RKMason/Subwoofer_3D_Print/Subsonic Mk3 Spec Sheet.pdf

# Subsonic Mk3

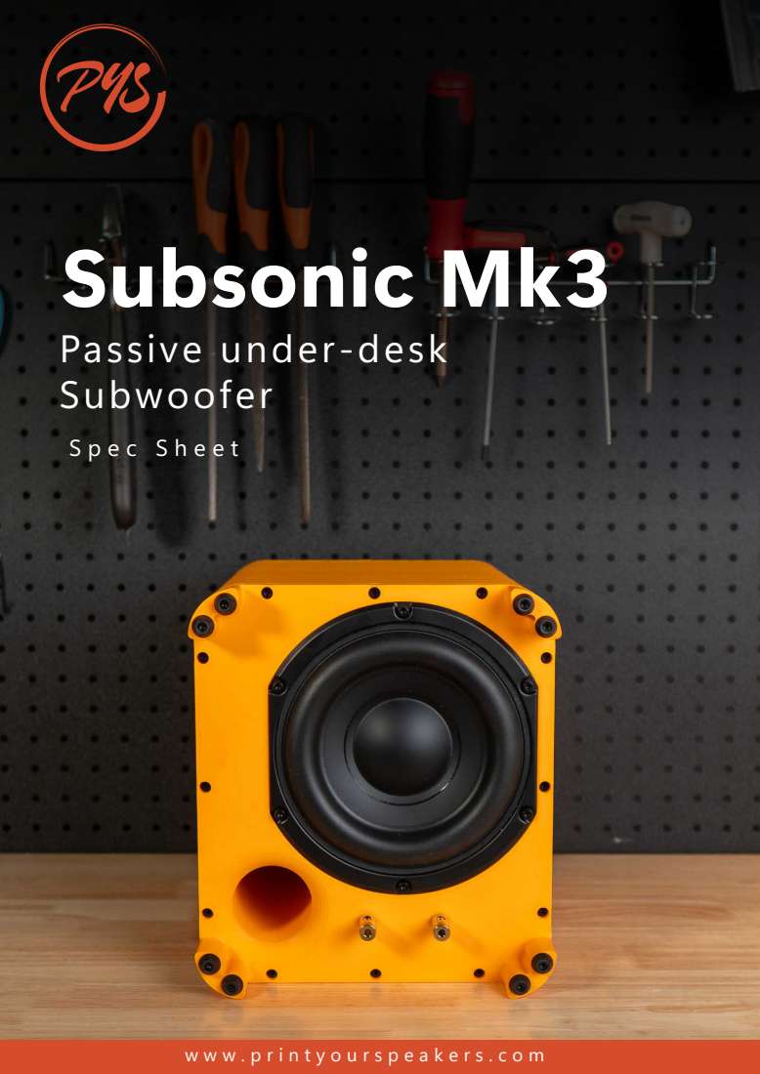
[picture p1: page 1]
Spec Sheet

Passive under-desk
Subwoofer

www.printyourspeakers.com

# SUBSONIC MK3 SPEC SHEET

## Description:

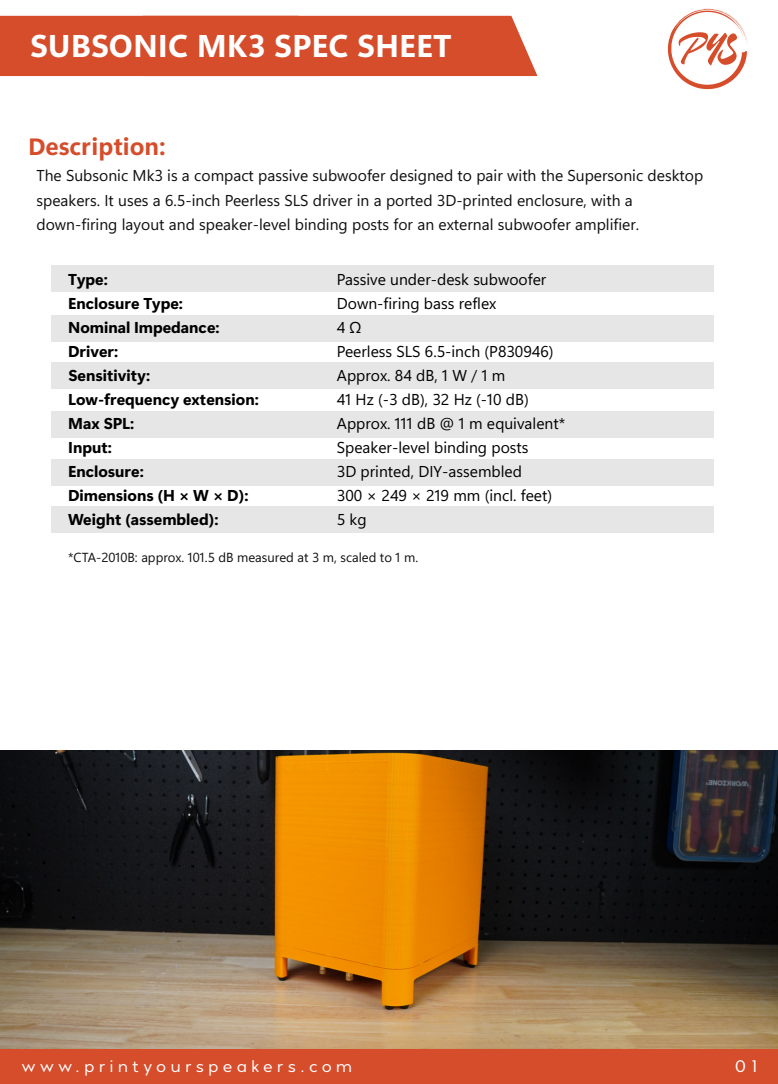
[picture p2: page 2]
www.printyourspeakers.com

The Subsonic Mk3 is a compact passive subwoofer designed to pair with the Supersonic desktop
speakers. It uses a 6.5-inch Peerless SLS driver in a ported 3D-printed enclosure, with a
down-firing layout and speaker-level binding posts for an external subwoofer amplifier.

Type:
Enclosure Type:
Nominal Impedance:
Driver:
Sensitivity:
Low-frequency extension:
Max SPL:
Input:
Enclosure:
Dimensions (H × W × D):
Weight (assembled):

Passive under-desk subwoofer
Down-firing bass reflex
Peerless SLS 6.5-inch (P830946)
Approx. 84 dB, 1 W / 1 m
Approx. 111 dB @ 1 m equivalent*
Speaker-level binding posts
3D printed, DIY-assembled
300 × 249 × 219 mm (incl. feet)

*CTA-2010B: approx. 101.5 dB measured at 3 m, scaled to 1 m.

# FREQUENCY RESPONSE & OUTPUT

*Ground-plane measurement at 1 m, 2 V (1 W into 4 Ω), no EQ. Approx. 84 dB sensitivity; 41 Hz (-3 dB), 32 Hz (-10 dB).

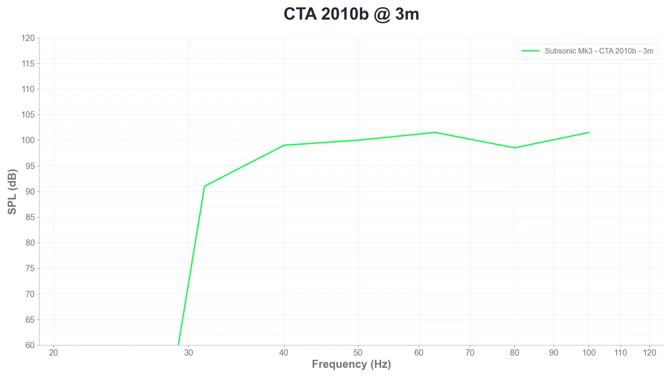
[picture p3: figure]

*CTA-2010B measured at 3 m; maximum approx. 101.5 dB. 1 m equivalent: approx. 111 dB (3 m measurement + 9.54 dB).

# IMPEDANCE

# MK2 VS MK3

*Frequency response comparison at 2 V (1 W into 4 Ω).

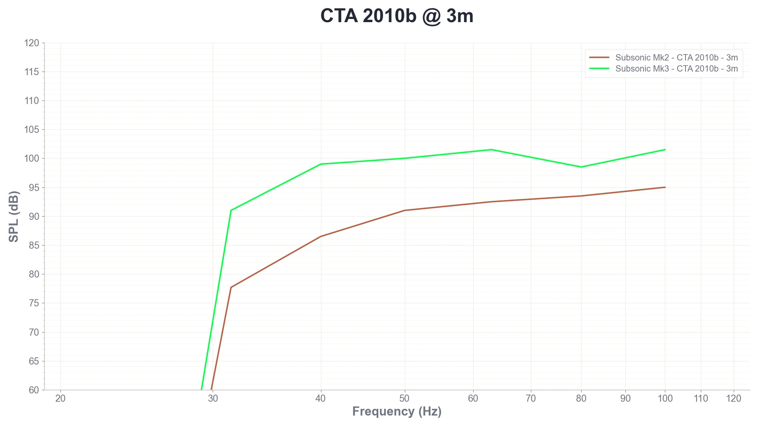
[picture p4: figure]

*CTA-2010B maximum output comparison, measured at 3 m.
