RKMason/Subwoofer_3D_Print/Baffle.step

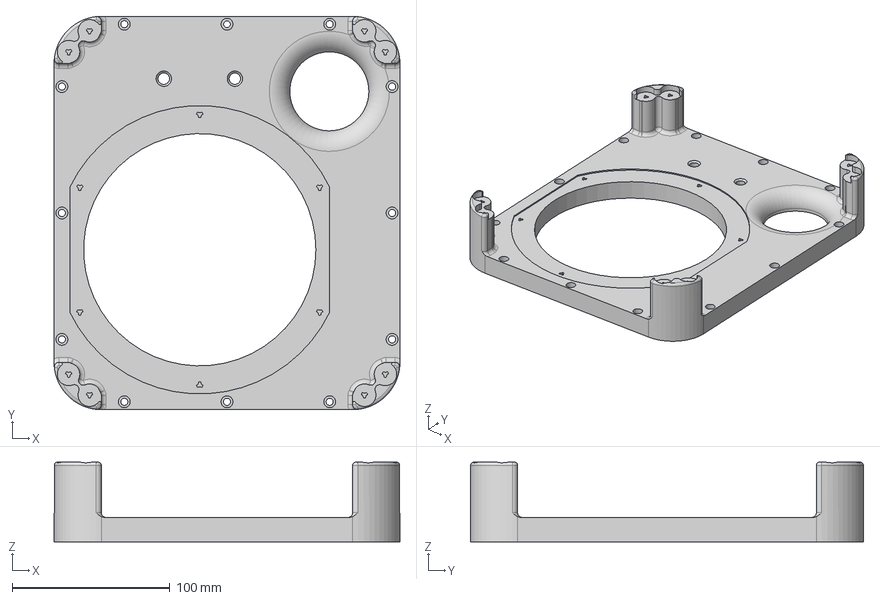
[picture p5: CAD file, 2026-09-30]
Baffle.step
219.0 x 249.0 x 50.5 mm
