RKMason/Subwoofer_3D_Print/Enclosure.step

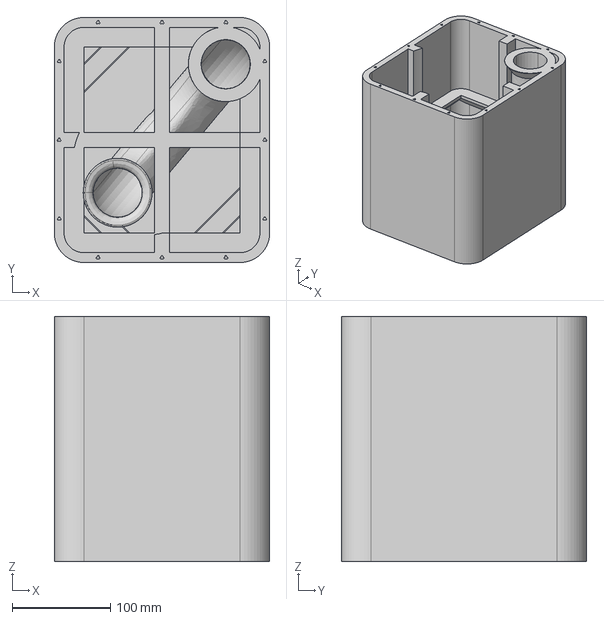
[picture p6: CAD file, 2026-09-30]
Enclosure.step
219.0 x 249.0 x 249.0 mm
