RKMason/Subwoofer_3D_Print/Bind Post Nut Driver.stl

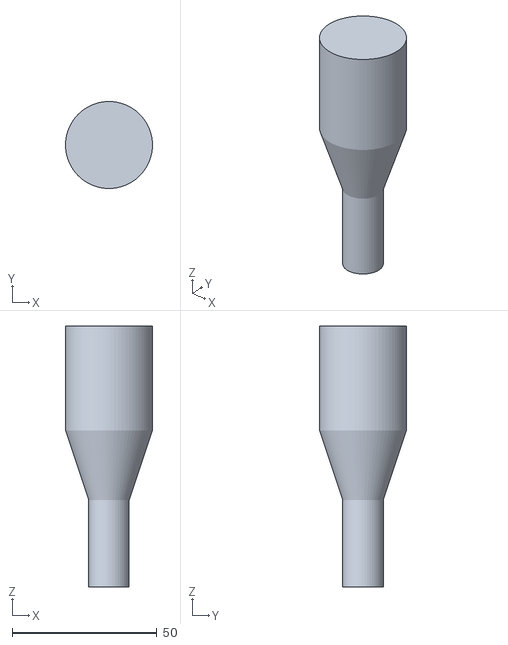
[picture p7: CAD file, 2026-10-03]
Bind Post Nut Driver.stl
30.0 x 30.0 x 90.0
