RKMason/Subwoofer_3D_Print/(list of files, cad)

Other CAD files:
Binding Post Nut Driver.step
Baffle.stl
Enclosure.stl
