RKMason/Subwoofer_3D_Print/Subsonic Mk3 Parts and Purchase Guide.pdf

# Subsonic Mk3

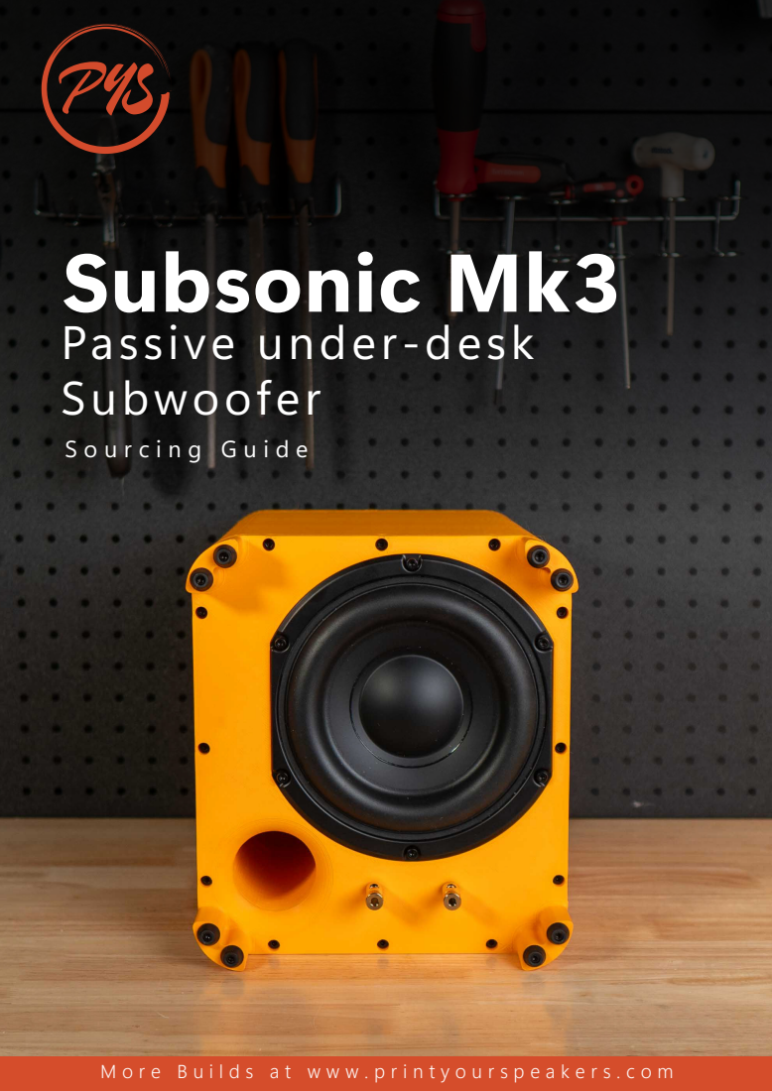
[picture p8: page 1]
Sourcing Guide

Passive under-desk
Subwoofer

More Builds at www.printyourspeakers.com

# SOURCING GUIDE

## Parts for one Subsonic Mk3

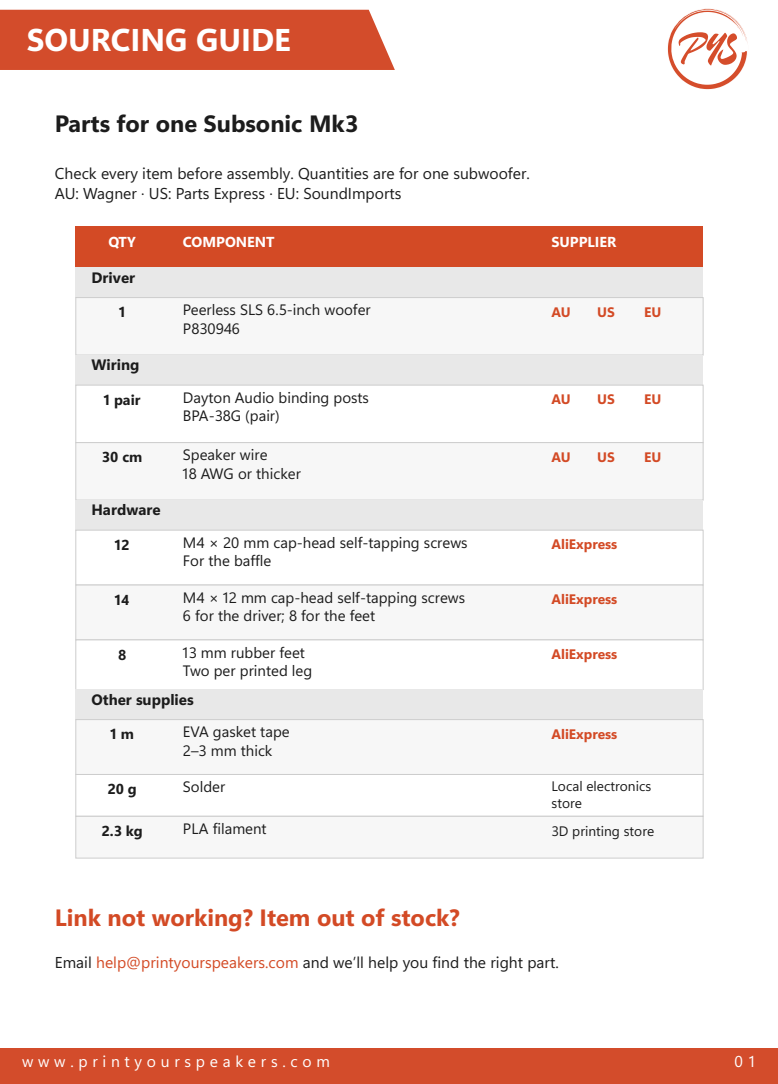
[picture p9: page 2]
www.printyourspeakers.com; QTY; COMPONENT; SUPPLIER; Driver; Peerless SLS 6.5-inch woofer; Wiring; 1 pair; Dayton Audio binding posts; BPA-38G (pair); Speaker wire; Hardware; M4 × 20 mm cap-head self-tapping screws; AliExpress; M4 × 12 mm cap-head self-tapping screws; 13 mm rubber feet; Other supplies; EVA gasket tape; 2–3 mm thick; Solder; Local electronics; store; PLA filament; 3D printing store

Check every item before assembly. Quantities are for one subwoofer.
AU: Wagner · US: Parts Express · EU: SoundImports

18 AWG or thicker

For the baffle

6 for the driver; 8 for the feet

Two per printed leg

Link not working? Item out of stock?

Email help@printyourspeakers.com and we’ll help you find the right part.
