RKMason/Subwoofer_3D_Print/Subsonic Mk3 Passive Assembly Guide.pdf

# Subsonic Mk3

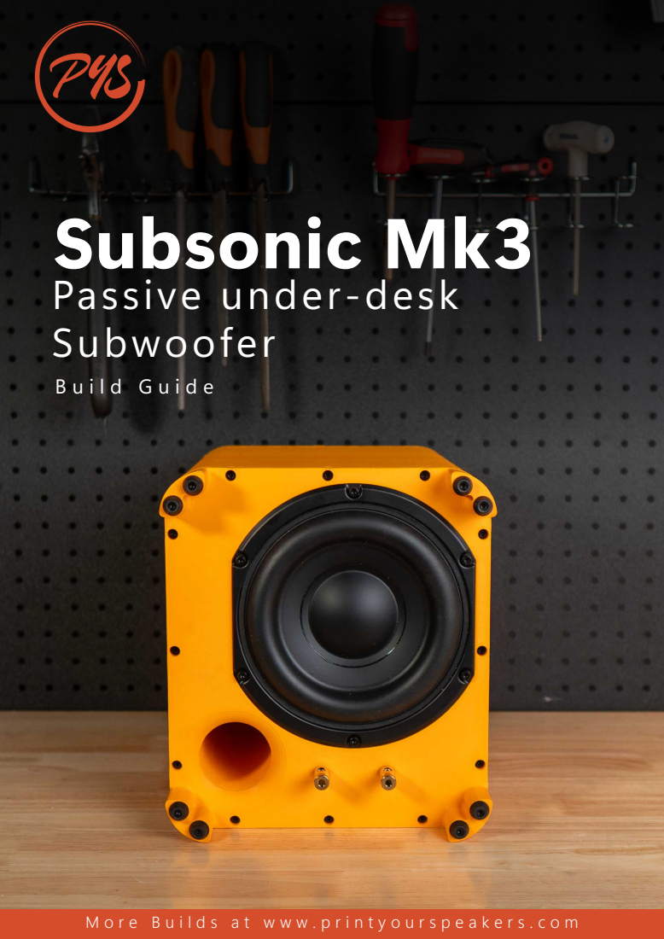
[picture p10: page 1]
Build Guide

Passive under-desk
Subwoofer

More Builds at www.printyourspeakers.com

# BEFORE YOU START

## You’re in the right place

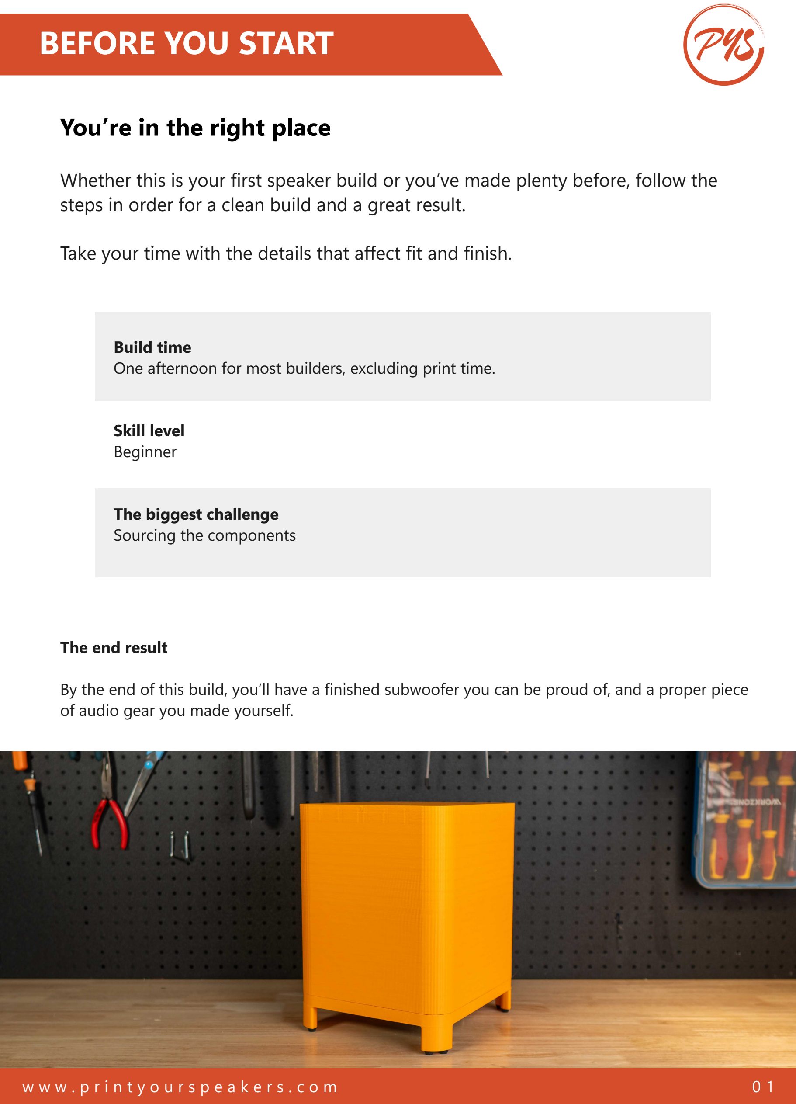
[picture p11: page 2]

www.printyourspeakers.com | 01

### Whether this is your first speaker build or you’ve made plenty before, follow the

steps in order for a clean build and a great result.

Take your time with the details that affect fit and finish.

Build time
One afternoon for most builders, excluding print time.

Skill level
Beginner

The biggest challenge
Sourcing the components

The end result

By the end of this build, you’ll have a finished subwoofer you can be proud of, and a proper piece of audio gear you made yourself.

Gather these tools and supplies for the build.

# TOOLS AND SUPPLIES

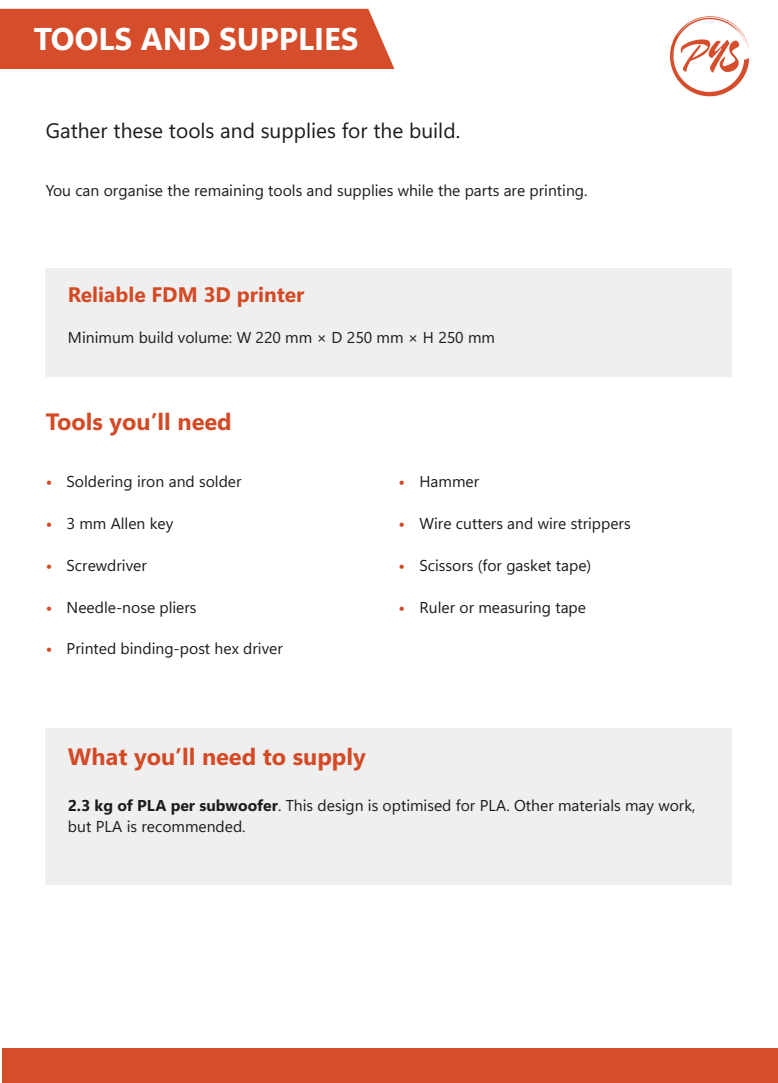
[picture p12: page 3]
• Screwdriver; • Hammer

You can organise the remaining tools and supplies while the parts are printing.

Reliable FDM 3D printer

Minimum build volume: W 220 mm × D 250 mm × H 250 mm

Tools you’ll need

• Soldering iron and solder

• 3 mm Allen key

• Wire cutters and wire strippers

• Scissors (for gasket tape)

• Needle-nose pliers

• Ruler or measuring tape

• Printed binding-post hex driver

What you’ll need to supply

2.3 kg of PLA per subwoofer. This design is optimised for PLA. Other materials may work,
but PLA is recommended.

PLA (tested and validated)

## Recommended material

# 3D PRINTING SETTINGS

## These settings have been tested on common FDM printers to

produce parts that fit and assemble correctly.

Other materials may work, but this build guide assumes PLA.

Parts are pre-oriented for printing. Do not rotate them.

## Part orientation

Check the orientation against the examples on the next page.

The main enclosure may take 48 hours or more to print. This is normal.

## Print time

The baffle may print in as little as a few hours.

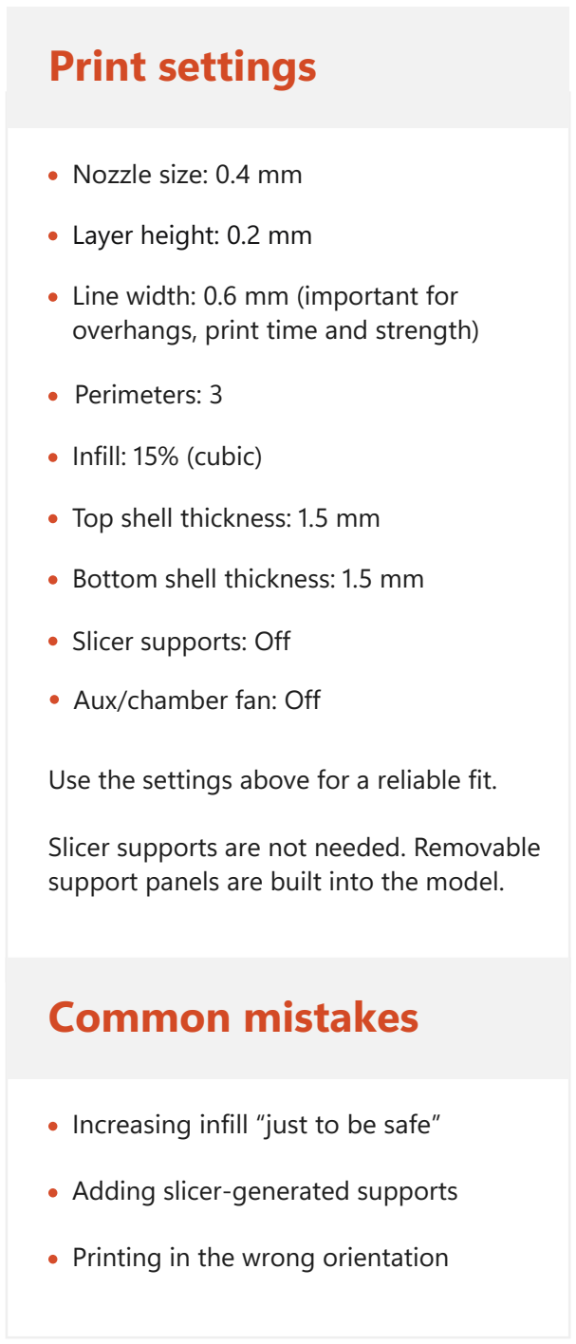
[picture p13: figure]
Nozzle size: 0.4 mm; Print settings; Layer height: 0.2 mm; Perimeters: 3; Top shell thickness: 1.5 mm; Bottom shell thickness: 1.5 mm; Slicer supports: Off; Increasing infill “just to be safe”; Common mistakes; Adding slicer-generated supports; Infill: 15% (cubic); Printing in the wrong orientation; Line width: 0.6 mm (important for overhangs, print time and strength); Aux/chamber fan: Off

Use the settings above for a reliable fit.

Slicer supports are not needed. Removable support panels are built into the model.

Load the parts into your slicer to check the time on your printer.

Start with the baffle to confirm your settings before moving on to larger parts.

# ORIENTATION EXAMPLES

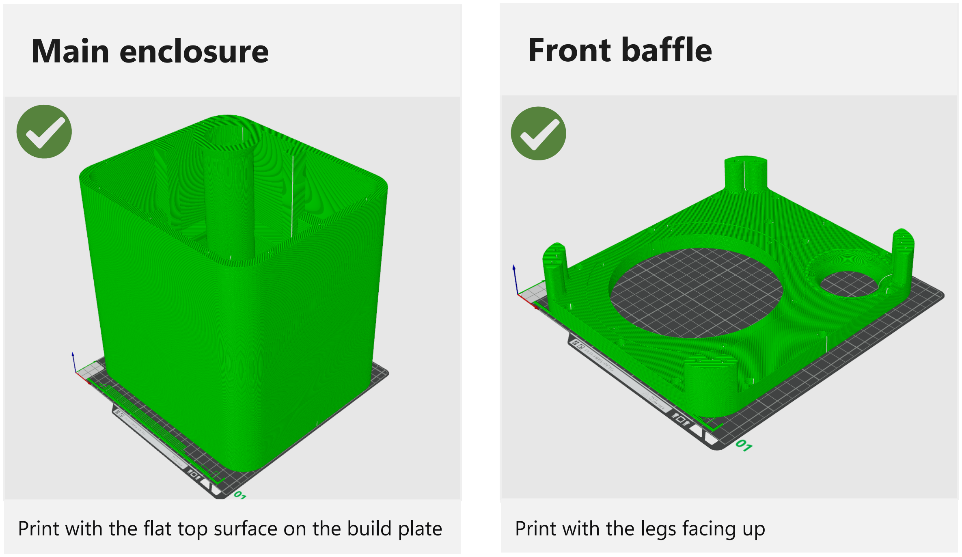
[picture p14: figure]
Main enclosure; Front baffle; Print with the legs facing up

Print with the flat top surface on the build plate

## Print all parts exactly as shown below

Keep the orientation shown. Rotating the parts may require extra supports and cause print failures.

Parts import in the correct orientation by default.

# ENCLOSURE PREP

## 1A Remove the supports

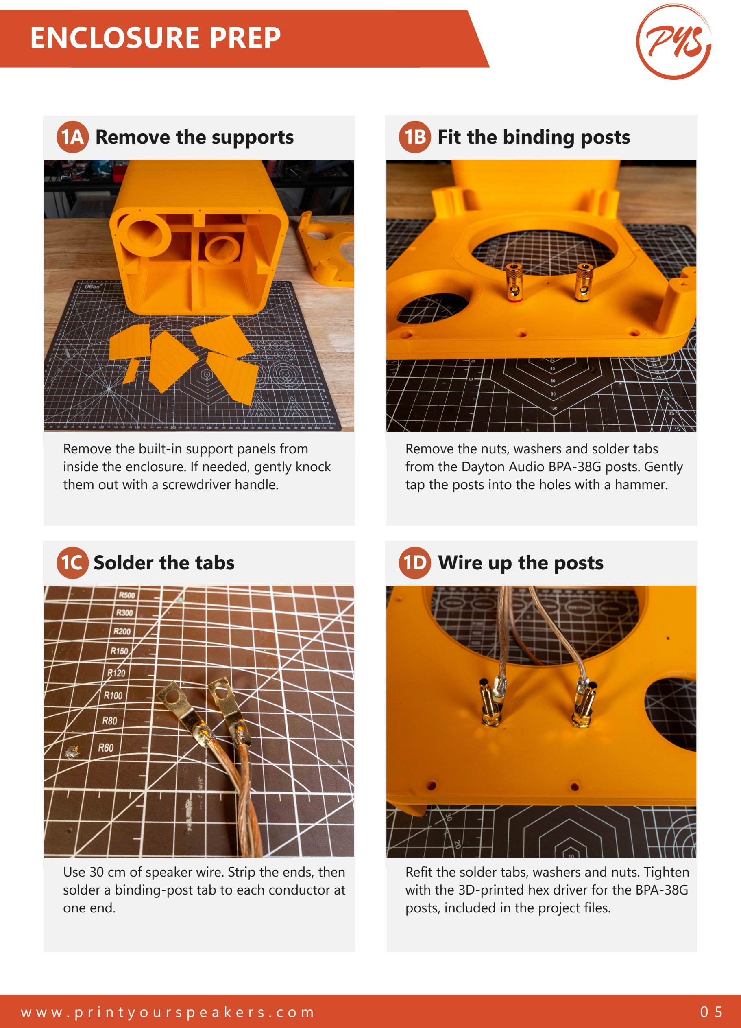
[picture p15: page 6]

Remove the built-in support panels from inside the enclosure. If needed, gently knock them out with a screwdriver handle.

Remove the nuts, washers and solder tabs from the Dayton Audio BPA-38G posts. Gently tap the posts into the holes with a hammer.

## 1B Fit the binding posts

Use 30 cm of speaker wire. Strip the ends, then solder a binding-post tab to each conductor at one end.

## 1C Solder the tabs

Refit the solder tabs, washers and nuts. Tighten with the 3D-printed hex driver for the BPA-38G posts, included in the project files.

## 1D Wire up the posts

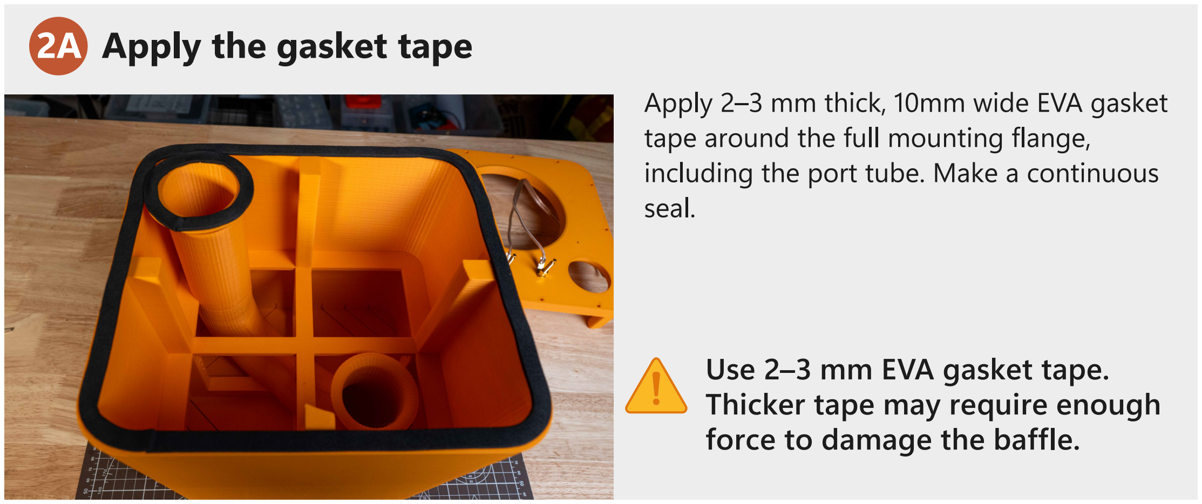
[picture p16: figure]
2A Apply the gasket tape; tape around the full mounting flange,; seal.; Use 2–3 mm EVA gasket tape. Thicker tape may require enough force to damage the baffle.

## 2B Secure the baffle

Apply 2–3 mm thick, 10mm wide EVA gasket

including the port tube. Make a continuous

Secure the baffle with twelve M4 × 20 mm self-tapping screws. Start all screws loosely, then tighten evenly in several passes until the gasket is compressed and the screws are firmly seated.

# ASSEMBLE THE ENCLOSURE

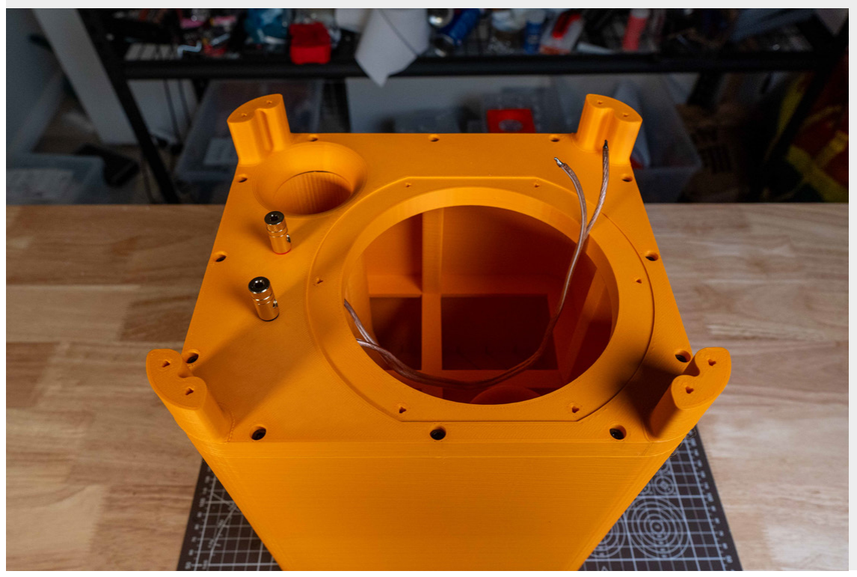
[picture p17: figure]

Next, mount the subwoofer driver.

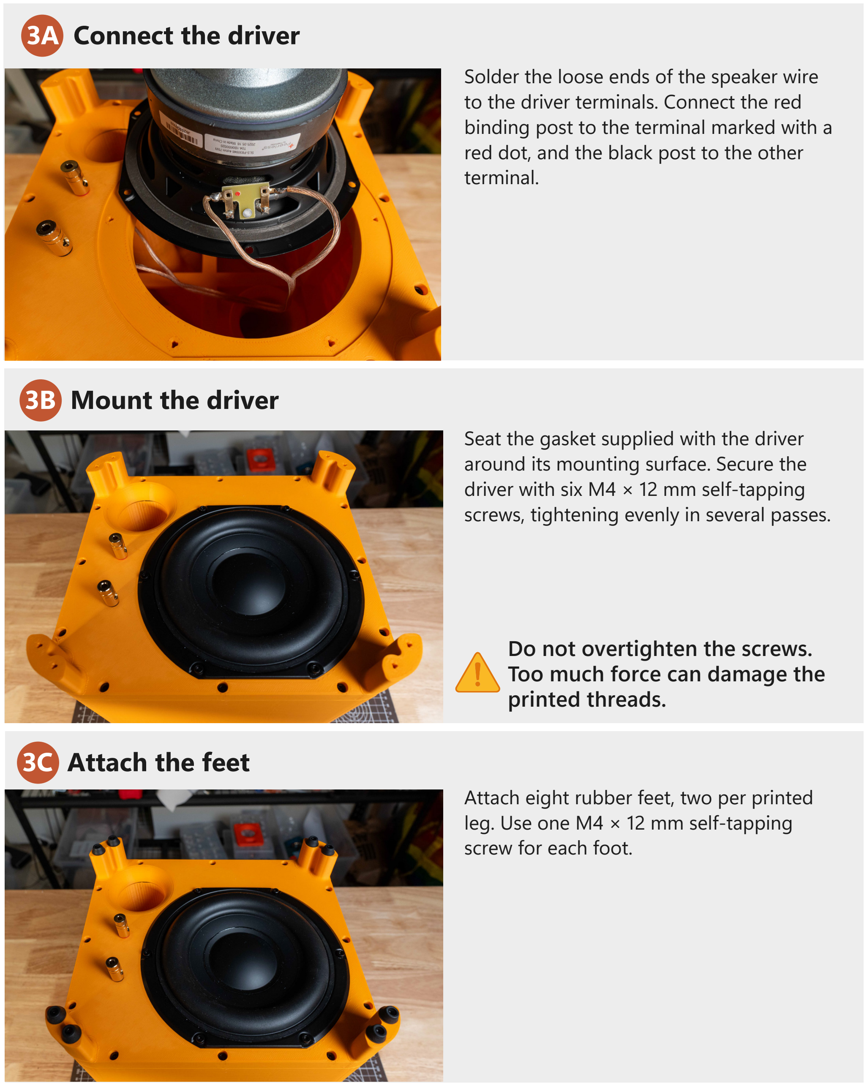
[picture p18: figure]
3C Attach the feet; leg. Use one M4 × 12 mm self-tapping screw for each foot.; 3B Mount the driver; 3A Connect the driver; terminal.; around its mounting surface. Secure the driver with six M4 × 12 mm self-tapping; Do not overtighten the screws. Too much force can damage the printed threads.

Attach eight rubber feet, two per printed

# MOUNTING THE DRIVER

Solder the loose ends of the speaker wire to the driver terminals. Connect the red binding post to the terminal marked with a red dot, and the black post to the other

Seat the gasket supplied with the driver

screws, tightening evenly in several passes.

# YOU BUILT THE SUBSONIC MK3

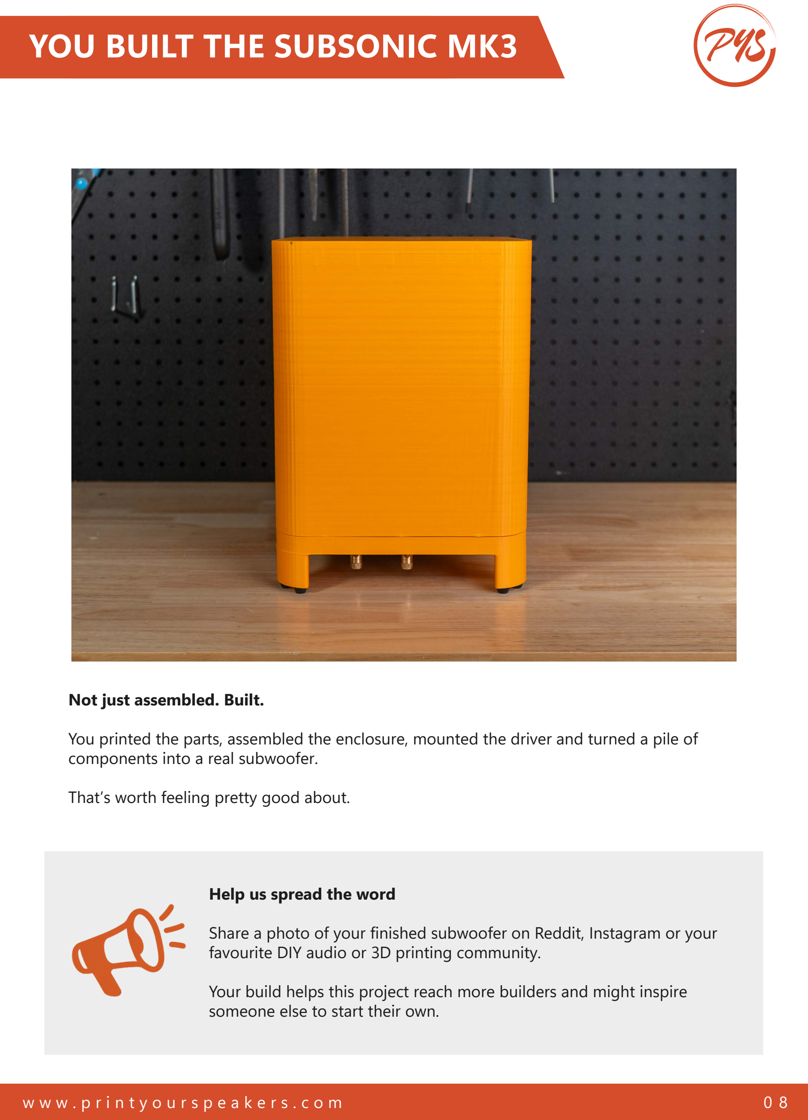
[picture p19: page 9]

Not just assembled. Built.

You printed the parts, assembled the enclosure, mounted the driver and turned a pile of components into a real subwoofer.

That’s worth feeling pretty good about.

Help us spread the word

Share a photo of your finished subwoofer on Reddit, Instagram or your favourite DIY audio or 3D printing community.

Your build helps this project reach more builders and might inspire someone else to start their own.

# TROUBLESHOOTING

No sound:
Check the connections at the driver and binding posts.

Hissing when bass hits:
Check the enclosure joints and driver gasket for air leaks.

Crackling, buzzing or distortion:
Check for loose connections, solder joints or objects inside the enclosure.

Amplifier shuts down or won’t power on:
Inspect the wiring for short circuits.

Weak bass or strange sound:
Verify polarity at every connection and keep the port unobstructed.

# Having trouble? Start here

Thanks for building with Print Your Speakers. Your feedback helps us improve the kits, guides and build experience.

Fill out the quick survey:
https://forms.gle/vGdJ8ECs8qqVMPcH6

Got more to say? Email feedback@printyourspeakers.com.

# We value your feedback

Still stuck? Email help@printyourspeakers.com. Chat with Hugh and fellow builders on Discord: https://discord.gg/SSNYCheZaB
